Abzazuet/MAP-project/VIdeo/Fotos/todo.jpeg

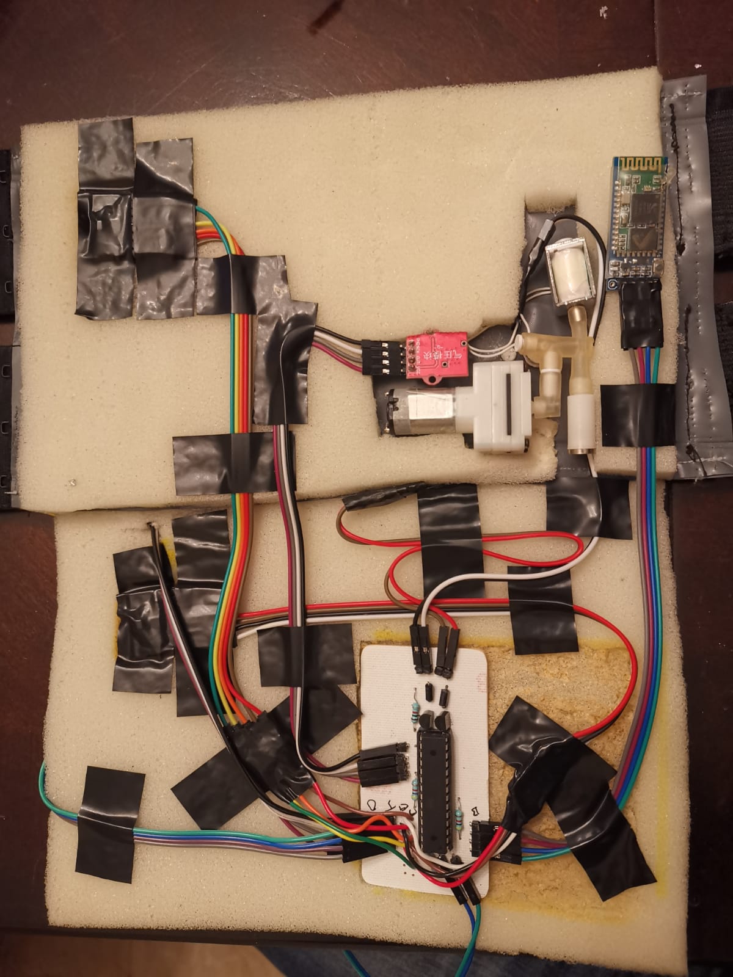
VIdeo/Fotos/todo.jpeg
