Abzazuet/MAP-project/VIdeo/Fotos/intro1.jpeg

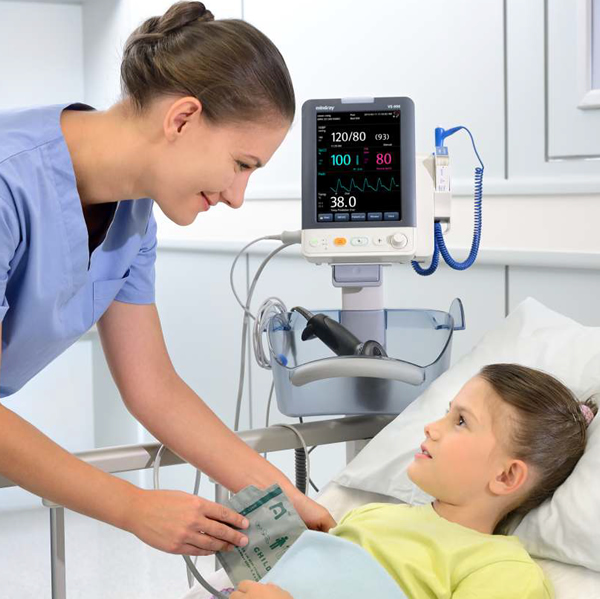
VIdeo/Fotos/intro1.jpeg
