Abzazuet/MAP-project/VIdeo/SeparacionVoces.odt

Daniela

Parte 1: Introducción, planteamiento del problema, antecedentes, justificación

Introducción: Conforme la humanidad va avanzando en tecnología se van buscando nuevos métodos para saber lo que pasa dentro del cuerpo humano y monitorizar los signos vitales para saber sí se tiene un buen estado de salud.

Hoy en día en el mundo se estima que al menos un 50% de la población mayor a los 50 años presenta problemas relacionados con el corazón.

Entre estos signos vitales se encuentra la presión arterial, el cual es el de nuestro mayor interés. Esto debido a que nos da una visión de lo que pasa con el corazón, dado que una presión alta puede indicar hipertensión o esfuerzo de más por parte del corazón. Y una presión baja puede presentar una deficiencia en los niveles de azúcar en la sangre

Justificación:

Este brazalete nos permitirá un monitoreo constante el cual vaya guardando registro de los pulsos por minuto, de la temperatura y de la PANI.

El módulo de biomecánica se acredita dado que el brazalete contiene dos giroscopios para sensar que la posición del brazo sea la adecuada y que así se obtenga una medición acertada.

El módulo de electrofisiología médica se acredita con el uso de sensores de oximetría, temperatura y presion arterial, sensando así signos vitales que pueden dar una noción más acertada de lo que está sucediendo

El módulo de instrumentación se acredita con la elaboración de un brazalete el cual va a tener todos estos sensores y puede ser analogado al monitor de signos vitales.

Guillermo

Parte 2: resultados y análisis de resultados

Resultados:

Ahora una demostración para explicar el funcionamiento de ambas partes concatenadas.

Primero el sujeto se coloca el brazalete, después se ingresa a la aplicación y se conecta al brazalete. Una vez conectado se habilita la opción de iniciar la medición y el brazalete comienza a inflarse.

Una vez terminado el proceso de inflado el microntrolador manda los datos al celular y esta la opción de guardar la medición en caso de que se quiera o está la opción de iniciar otra medición.

Una vez guardada la medicion nos podemos ir al menu de informes, donde nos aparecerán los datos guardados, organizados por fecha.

También está la opción de modificar los datos personales y de agregar una imagen de la persona.

Análisis de resultados:

Abel

Parte 3: Metodología

Para poder lograr acabo el proyecto este se dividio en dos partes fundamentales. La primera fue la programación de una aplicación móvil diseñada en el lenguaje dart con la extensión de flutter, la cual nos permiten hacer aplicaciones con estética y alta funcionalidad. En este mismo apartado se incluyo la programación del microcontrolador (el cual fue un ATMega 8), el cual fue programado en C con la librería avrdude, la cual nos permite programar microcontroladores de la tecnología AVR.

El siguiente apartado fue el armado del brazalete donde se concateno el microcontrolador para sensar los sensores de posición, temperatura, presión y pulso. Para que el brazalete tuviera funcionalidad y pudiera regresar a su estado original se utilizó un tipo de plástico, el cual tiene la capacidad de aguantar presiones que llegan a los 160mmHg (aunque lo que se utiliza aire, estas son las unidades en las que se presenta la PANI). Una vez teniendo la parte del brazalete que se infla se procedió a poner una espuma por debajo del brazalete, esto con el fin de que haya la menor incomodidad posible y también con el fin de poner los sensores que requieren de contacto con la persona que utilice el brazalete. El paso final fue colocal la tarjeta electrónica en el brazalete para que se comuniquen los sensores, el brazalete, el microcontrolador y nuestro celular. El celular y el brazalete se comunican por un modulo de bluetooth, el HC-05.
