Abzazuet/MAP-project/VIdeo/Fotos/androidstudio.jpeg

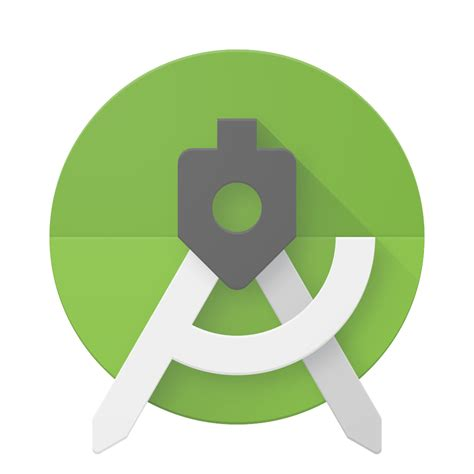
VIdeo/Fotos/androidstudio.jpeg
