Abzazuet/MAP-project/VIdeo/Fotos/atmega8.jpeg

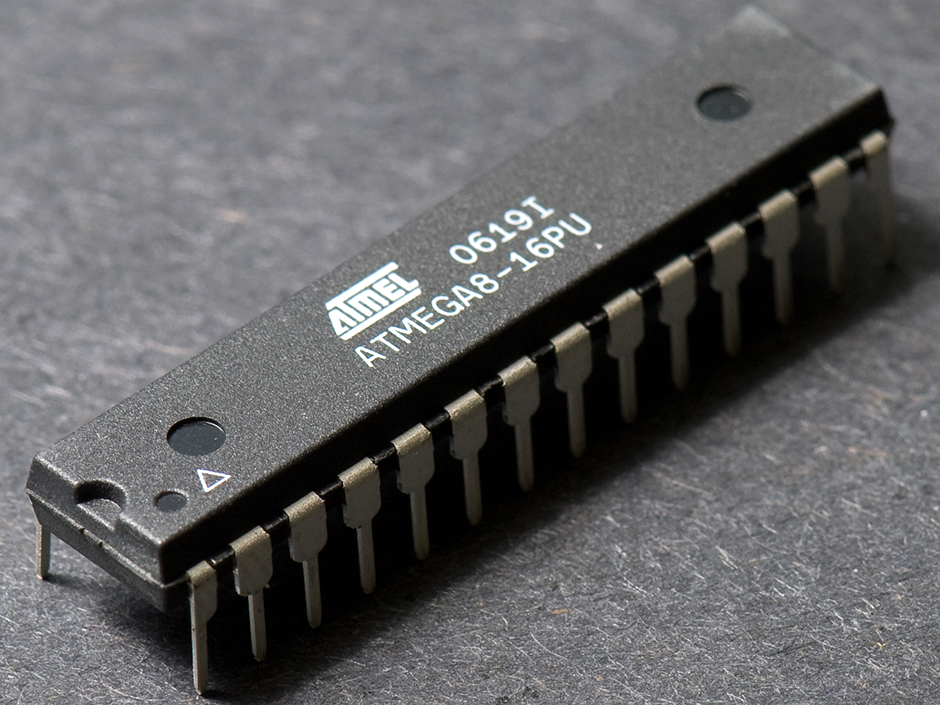
VIdeo/Fotos/atmega8.jpeg
