Abzazuet/MAP-project/VIdeo/Fotos/avr.jpeg

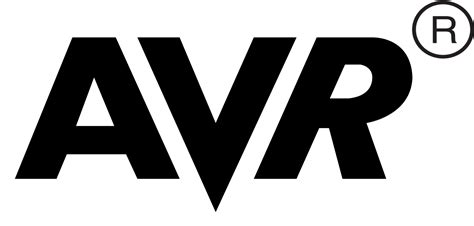
VIdeo/Fotos/avr.jpeg
