Abzazuet/MAP-project/VIdeo/Fotos/brazalete.jpeg

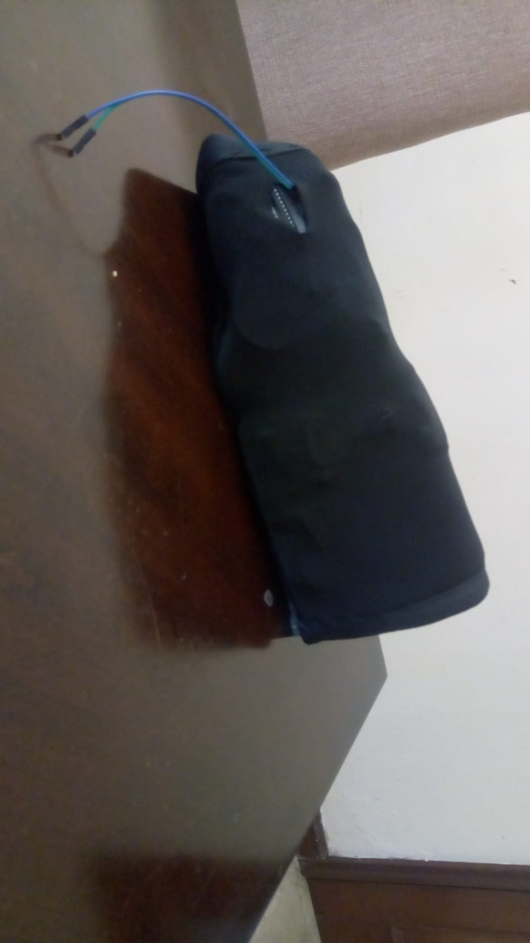
VIdeo/Fotos/brazalete.jpeg
