Abzazuet/MAP-project/VIdeo/Fotos/brazaleteProtipo.jpeg

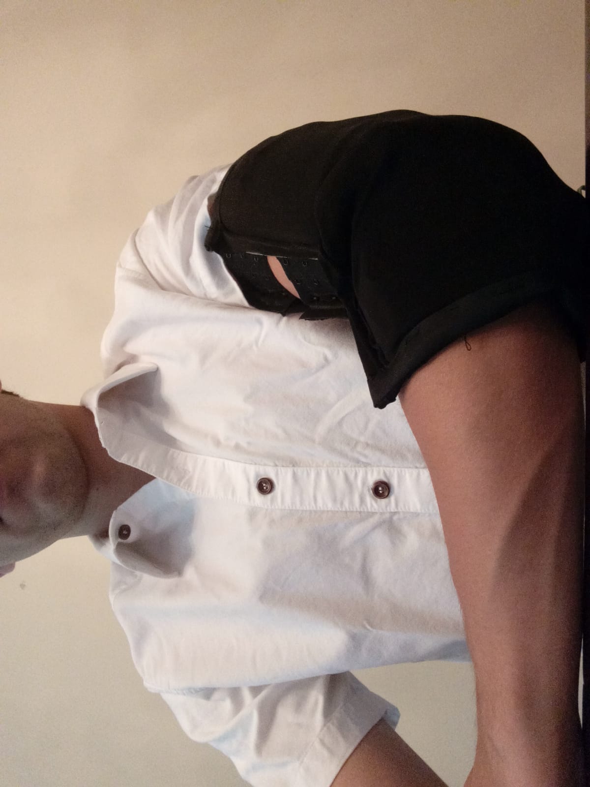
VIdeo/Fotos/brazaleteProtipo.jpeg
