Abzazuet/MAP-project/VIdeo/Fotos/bt.jpeg

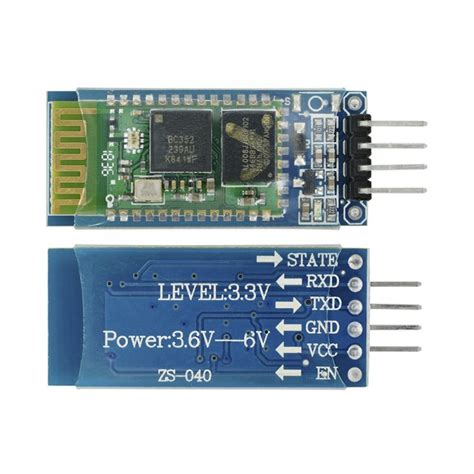
VIdeo/Fotos/bt.jpeg
