Abzazuet/MAP-project/VIdeo/Fotos/corazonInicio.jpg

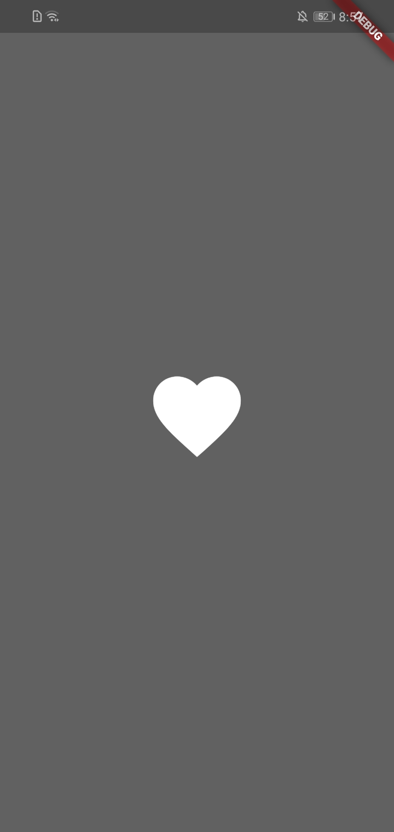
VIdeo/Fotos/corazonInicio.jpg
