Abzazuet/MAP-project/VIdeo/Fotos/Datos.jpg

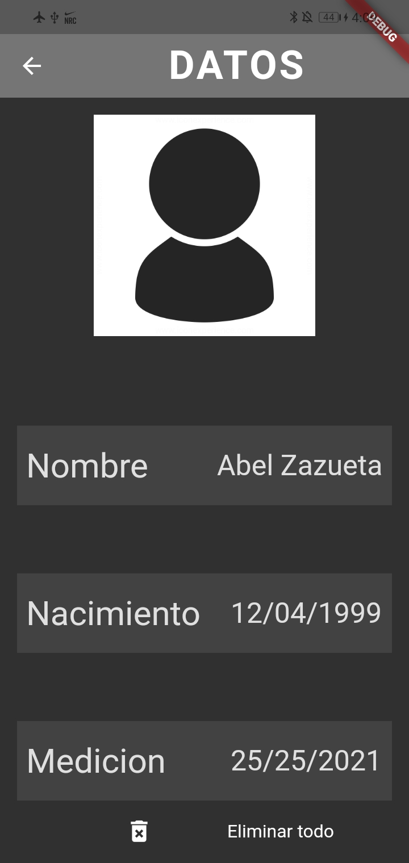
VIdeo/Fotos/Datos.jpg
