Abzazuet/MAP-project/VIdeo/Fotos/espuma.jpeg

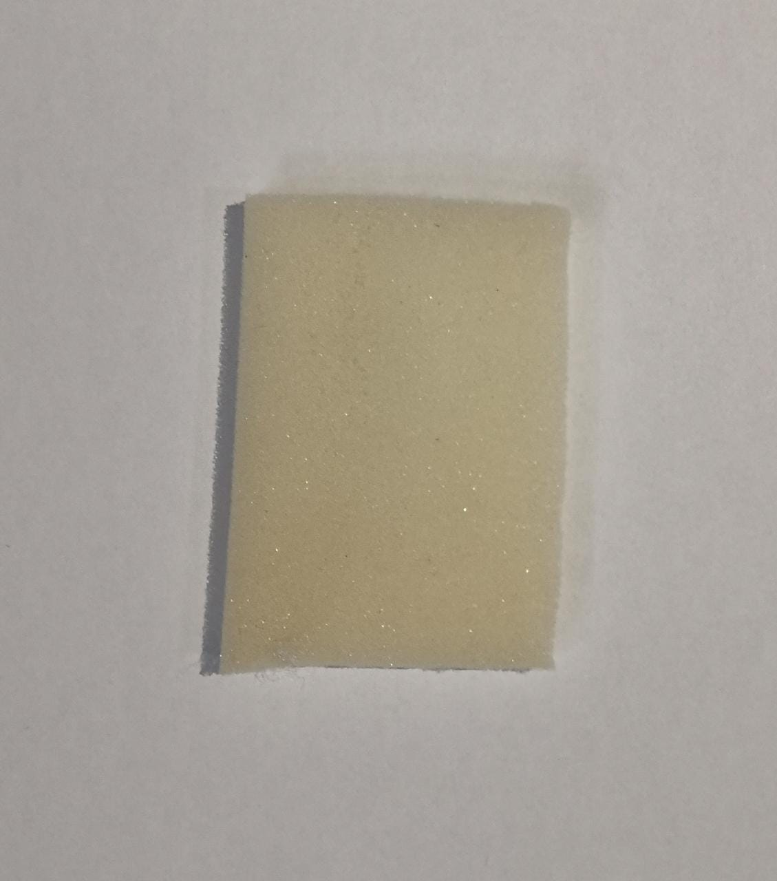
VIdeo/Fotos/espuma.jpeg
