Abzazuet/MAP-project/VIdeo/Fotos/flutterDart.png

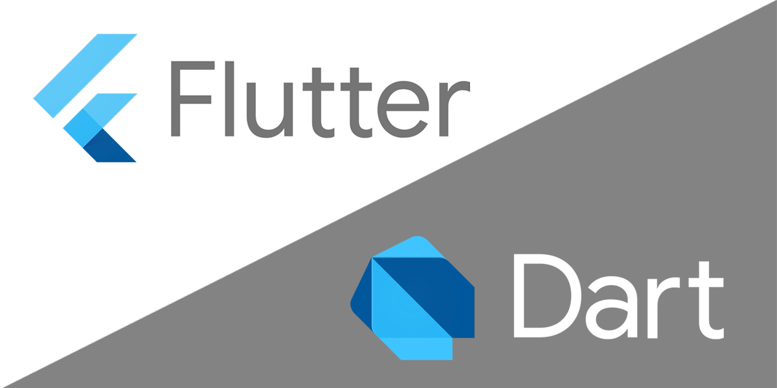
VIdeo/Fotos/flutterDart.png
