Abzazuet/MAP-project/VIdeo/Fotos/giros.jpeg

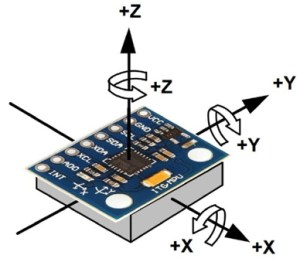
VIdeo/Fotos/giros.jpeg
