Abzazuet/MAP-project/VIdeo/Fotos/girosBrazalete.jpeg

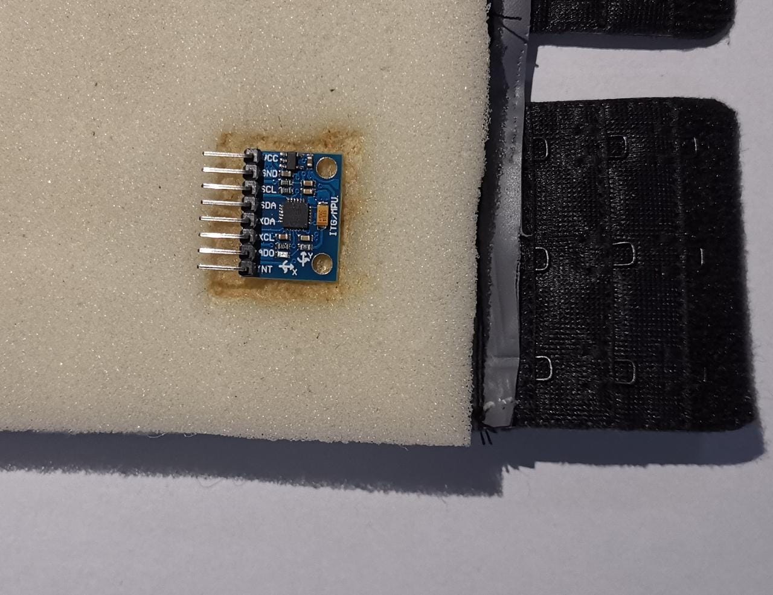
VIdeo/Fotos/girosBrazalete.jpeg
