Abzazuet/MAP-project/VIdeo/Fotos/Informe.jpg

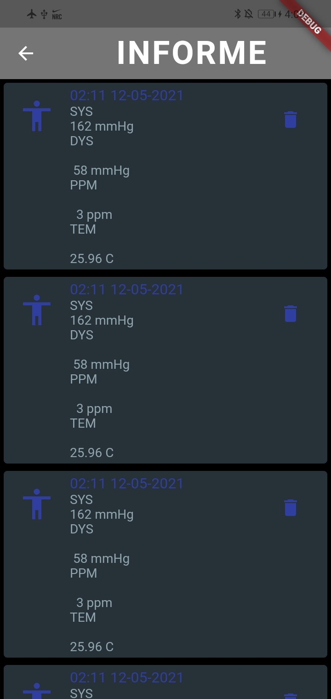
VIdeo/Fotos/Informe.jpg
