Abzazuet/MAP-project/VIdeo/Fotos/Inicio.jpg

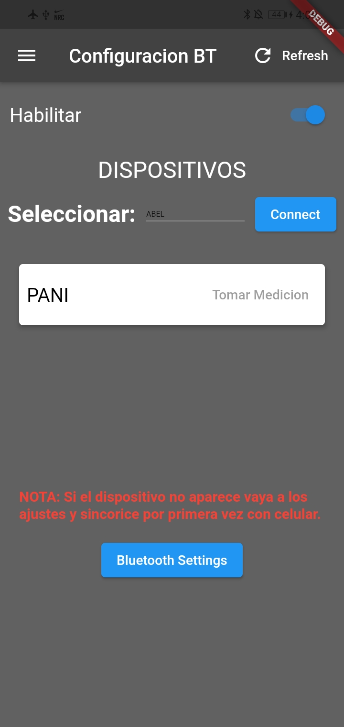
VIdeo/Fotos/Inicio.jpg
