Abzazuet/MAP-project/VIdeo/Fotos/Medicion.jpg

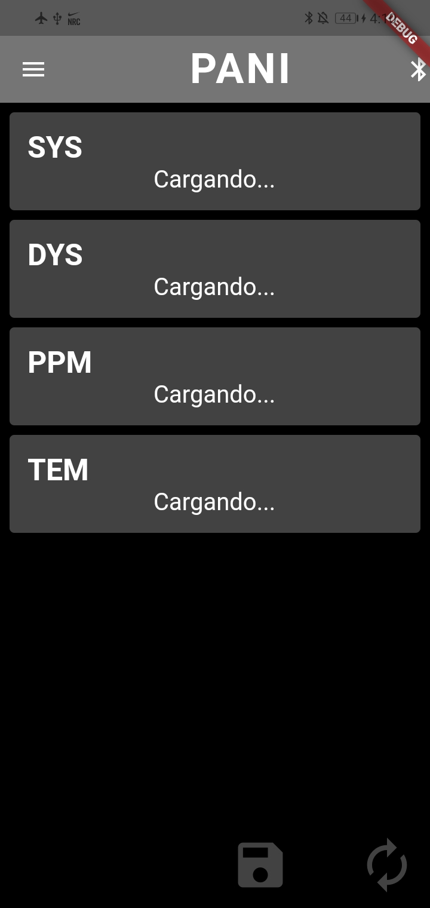
VIdeo/Fotos/Medicion.jpg
