Abzazuet/MAP-project/VIdeo/Fotos/motorBrazalete.jpeg

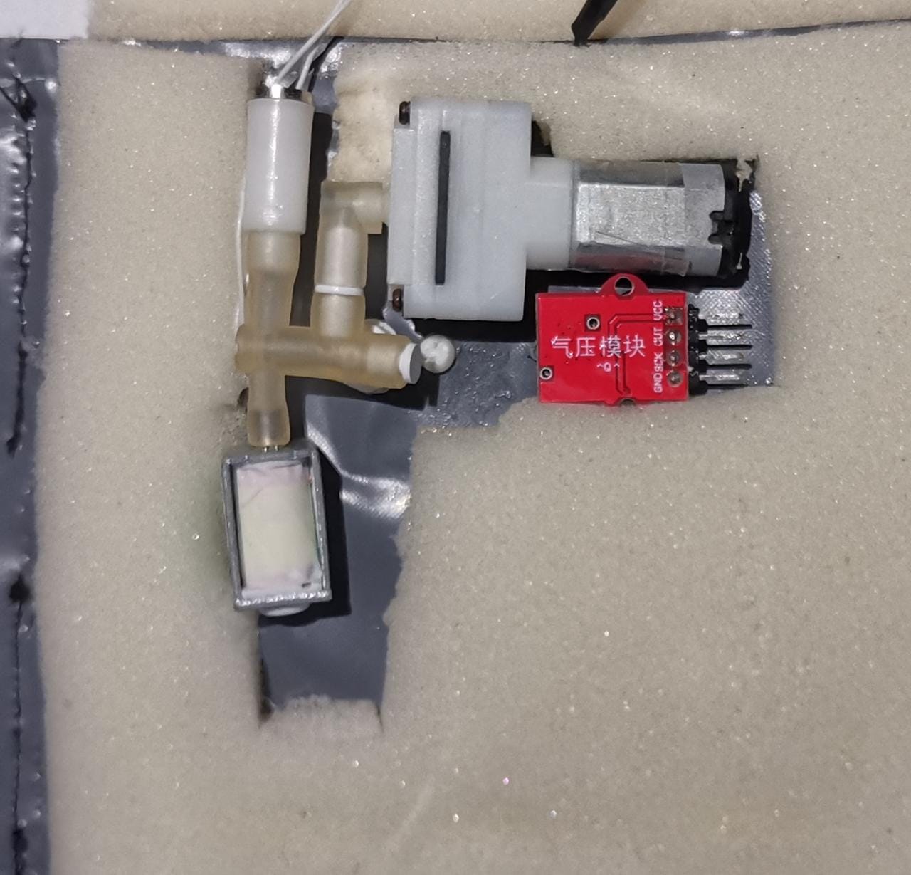
VIdeo/Fotos/motorBrazalete.jpeg
