Abzazuet/MAP-project/VIdeo/Fotos/msv.jpeg

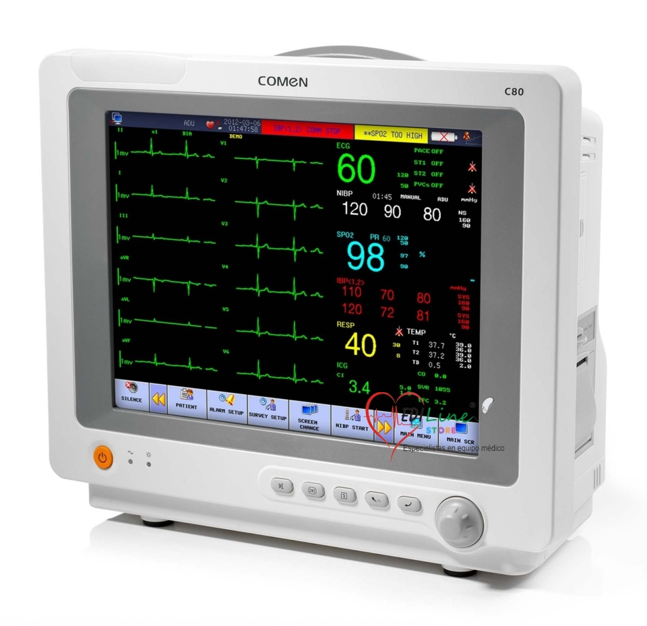
VIdeo/Fotos/msv.jpeg
