Abzazuet/MAP-project/VIdeo/Fotos/Opciones.jpg

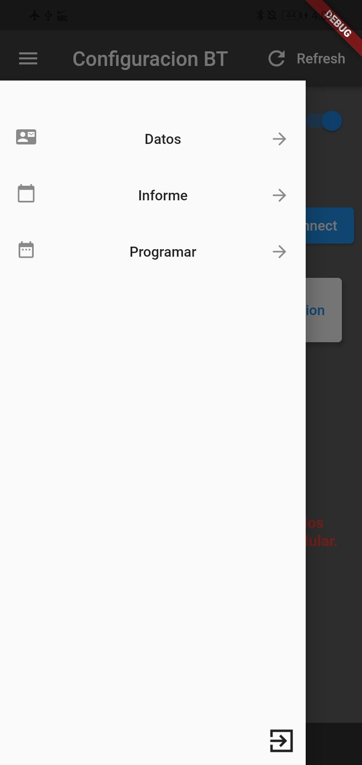
VIdeo/Fotos/Opciones.jpg
