Abzazuet/MAP-project/VIdeo/Fotos/oscilatorio.jpeg

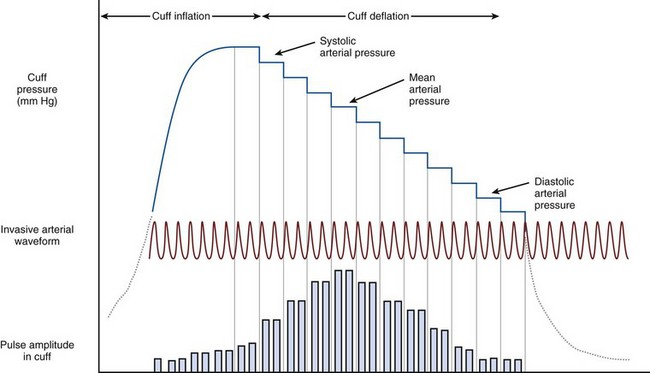
VIdeo/Fotos/oscilatorio.jpeg
