Abzazuet/MAP-project/VIdeo/Fotos/oscilometrico2.png

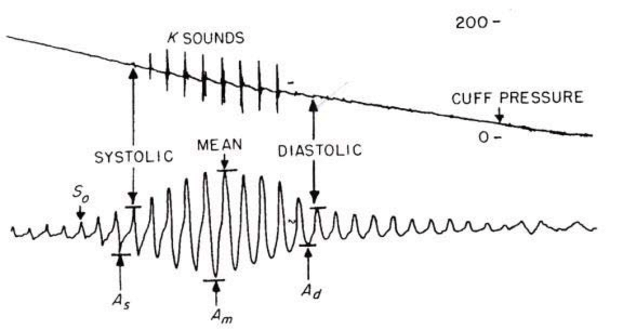
VIdeo/Fotos/oscilometrico2.png
