Abzazuet/MAP-project/VIdeo/Fotos/oximetria.jpeg

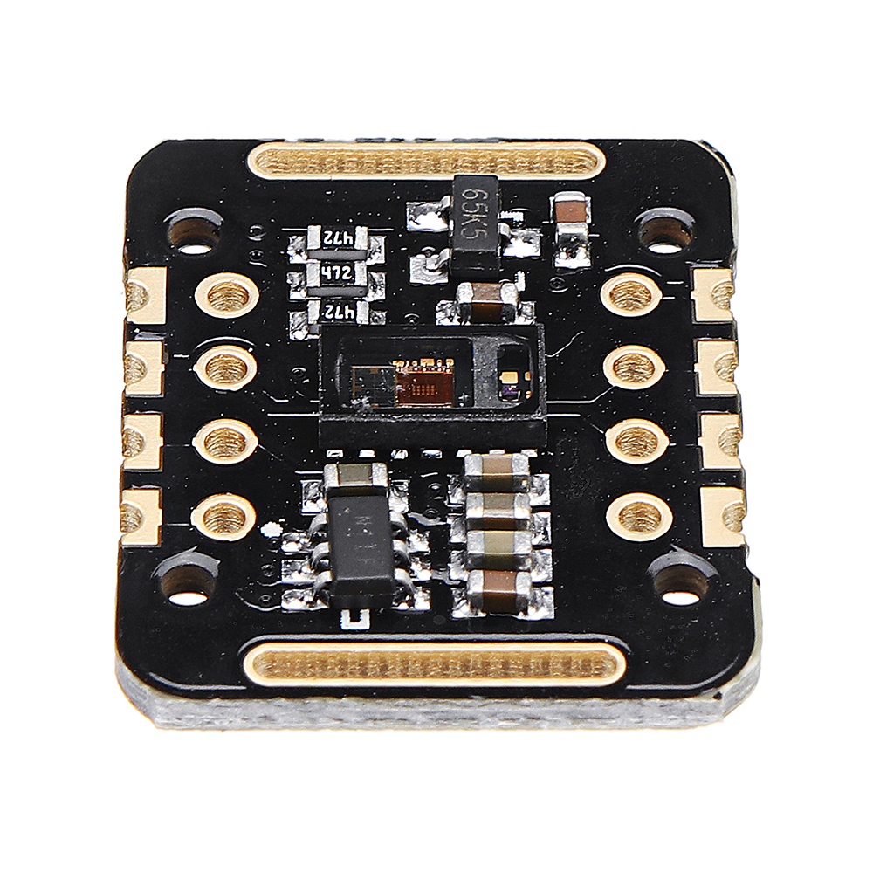
VIdeo/Fotos/oximetria.jpeg
