Abzazuet/MAP-project/VIdeo/Fotos/pesoBrazaleteNuestro.jpeg

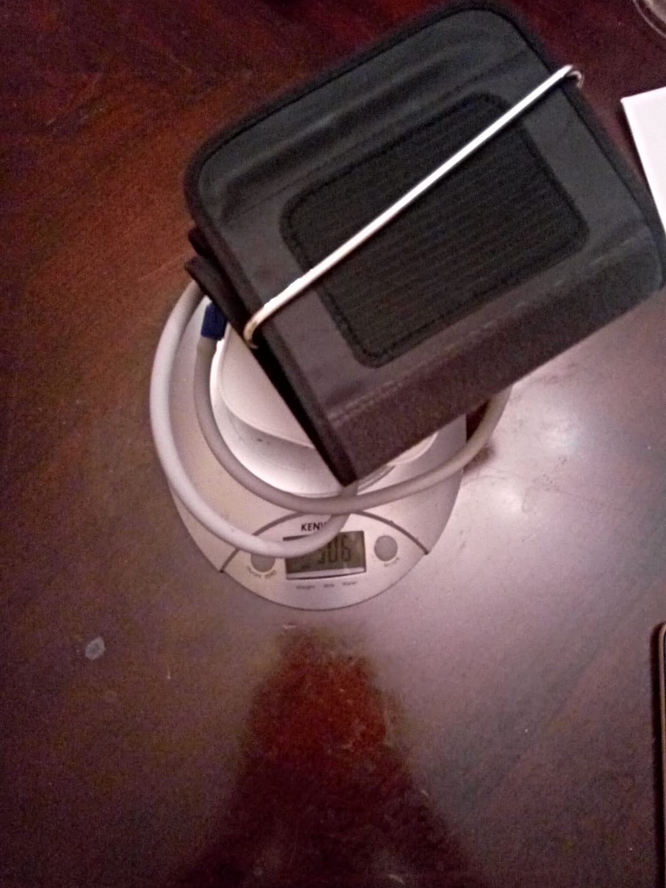
VIdeo/Fotos/pesoBrazaleteNuestro.jpeg
