Abzazuet/MAP-project/VIdeo/Fotos/pesoPrototipo.jpeg

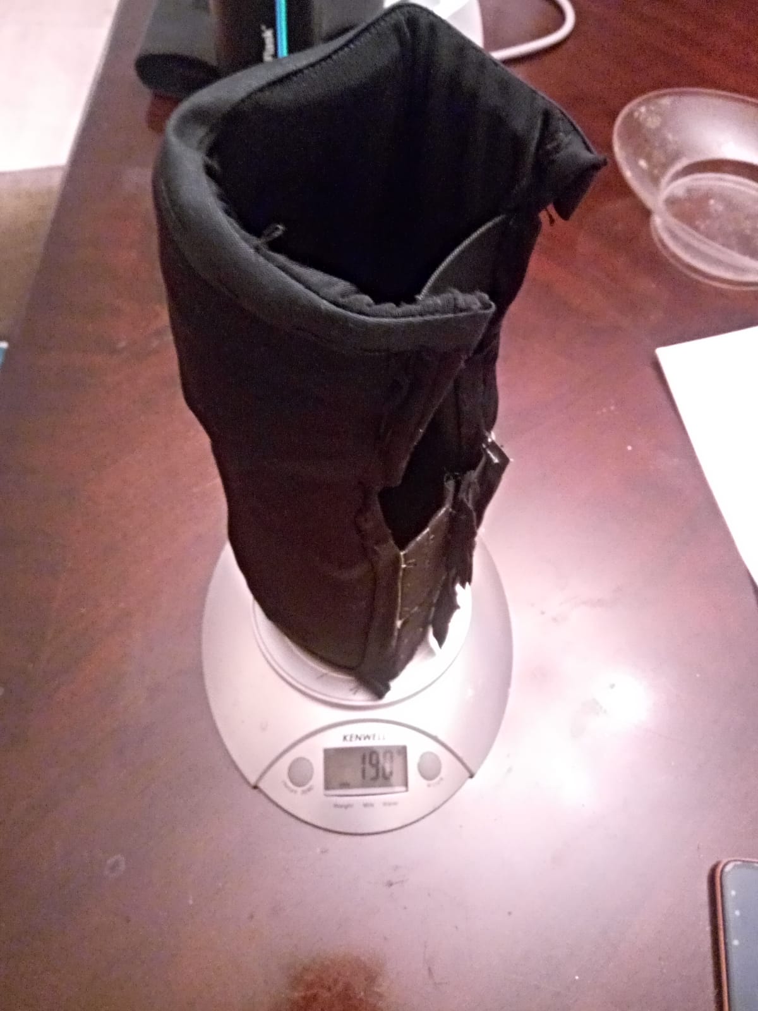
VIdeo/Fotos/pesoPrototipo.jpeg
