Abzazuet/MAP-project/VIdeo/Fotos/presion.jpeg

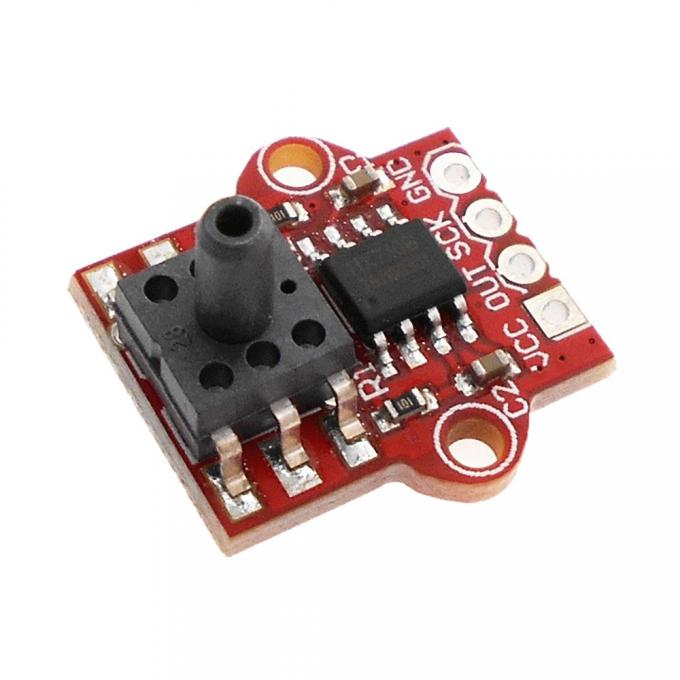
VIdeo/Fotos/presion.jpeg
