Abzazuet/MAP-project/VIdeo/Fotos/resorte.jpeg

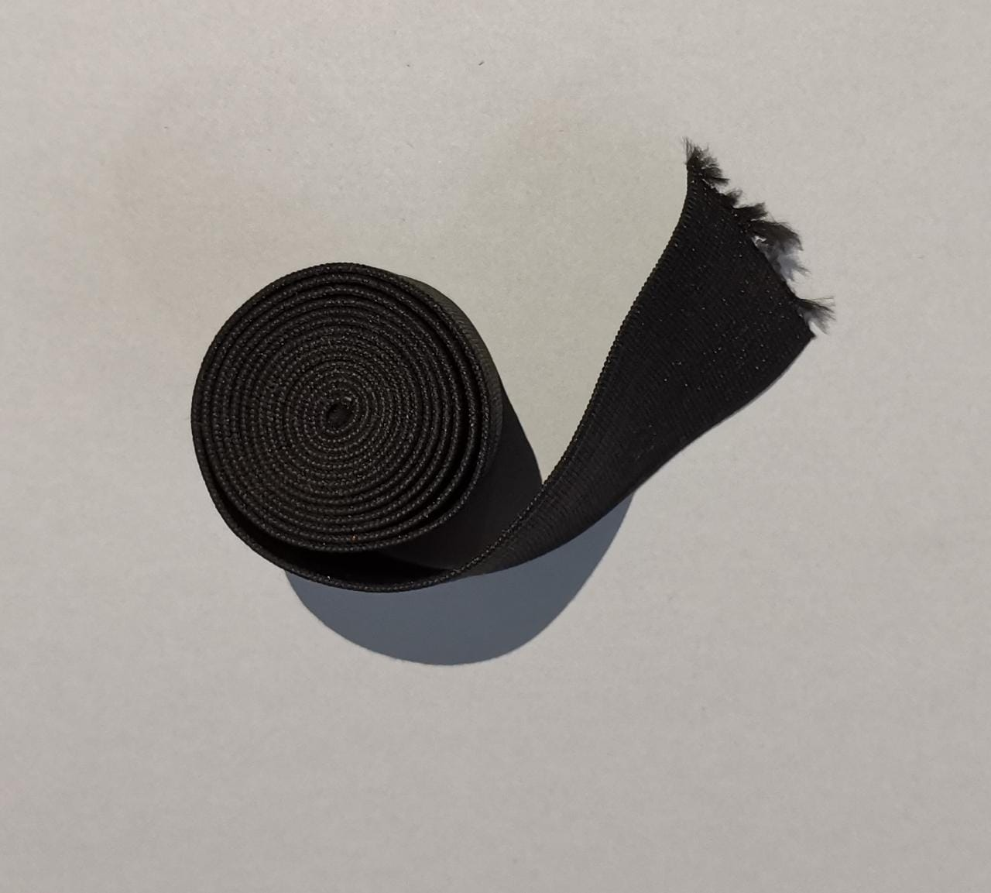
VIdeo/Fotos/resorte.jpeg
