Abzazuet/MAP-project/VIdeo/Fotos/sensoresPiel.jpeg

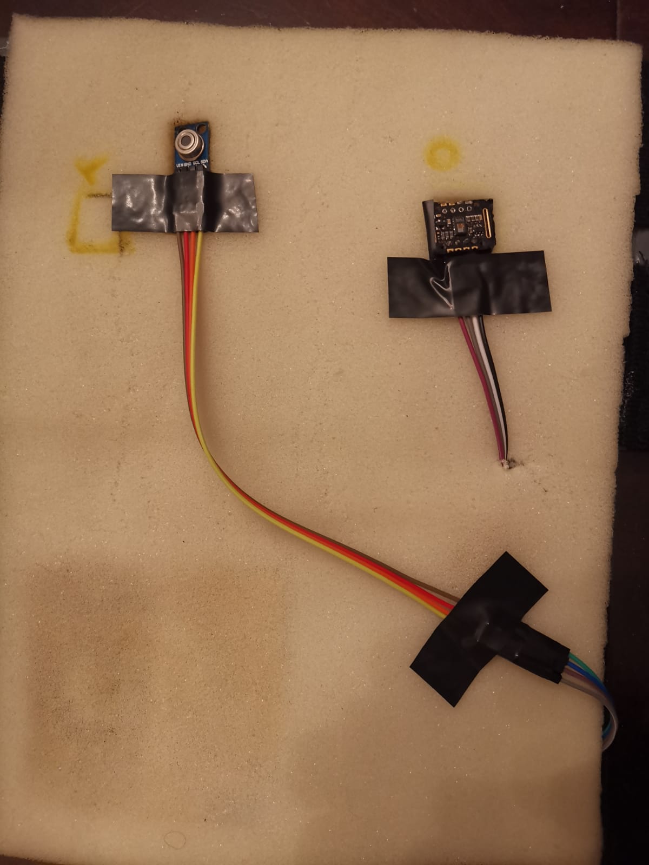
VIdeo/Fotos/sensoresPiel.jpeg
