Abzazuet/MAP-project/VIdeo/Fotos/telaInflable.jpeg

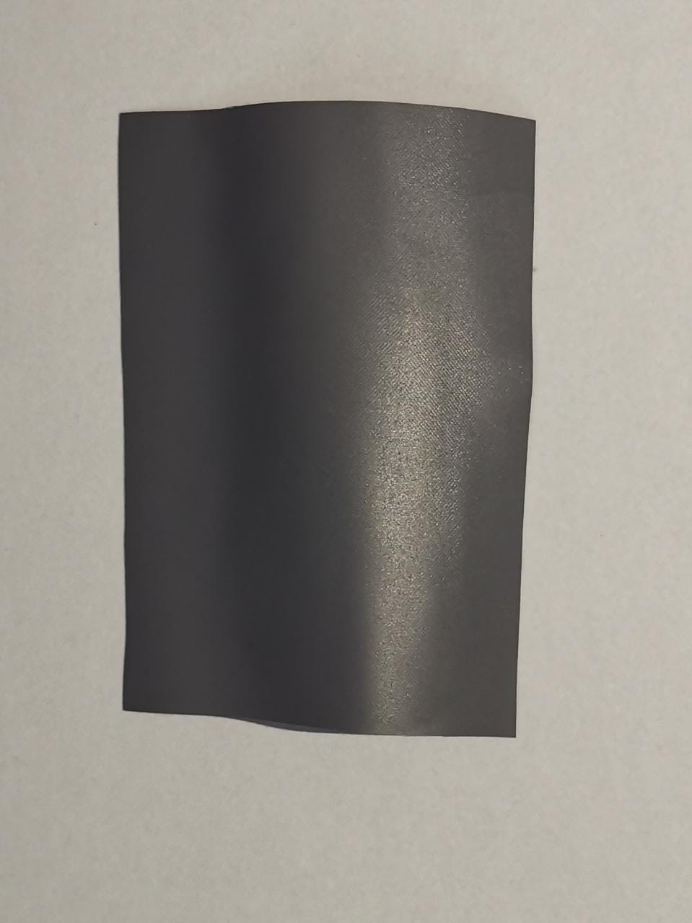
VIdeo/Fotos/telaInflable.jpeg
