Abzazuet/MAP-project/VIdeo/Fotos/temp.jpeg

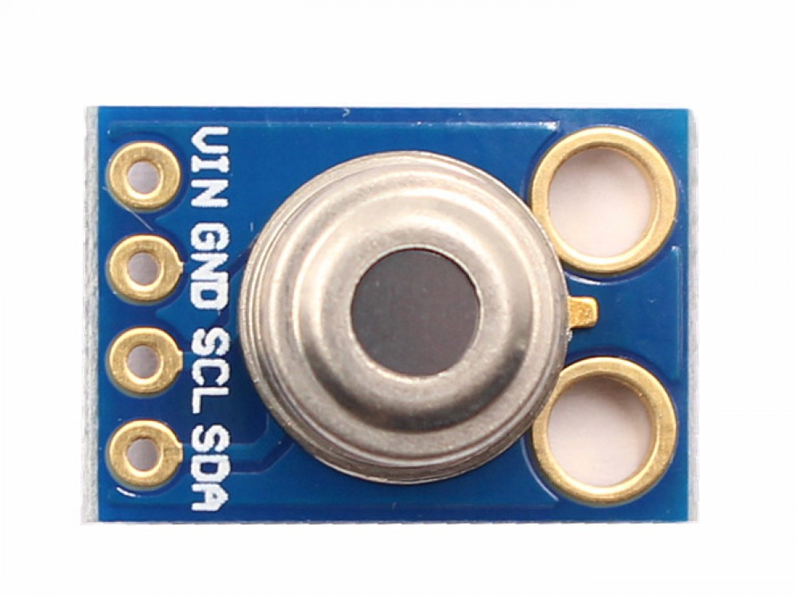
VIdeo/Fotos/temp.jpeg
