Abzazuet/MAP-project/(list of files, cad)

Other CAD files:
VIdeo/ProyectoModular.blend
