Abzazuet/MAP-project/pcb/pcb-esquematico.pdf

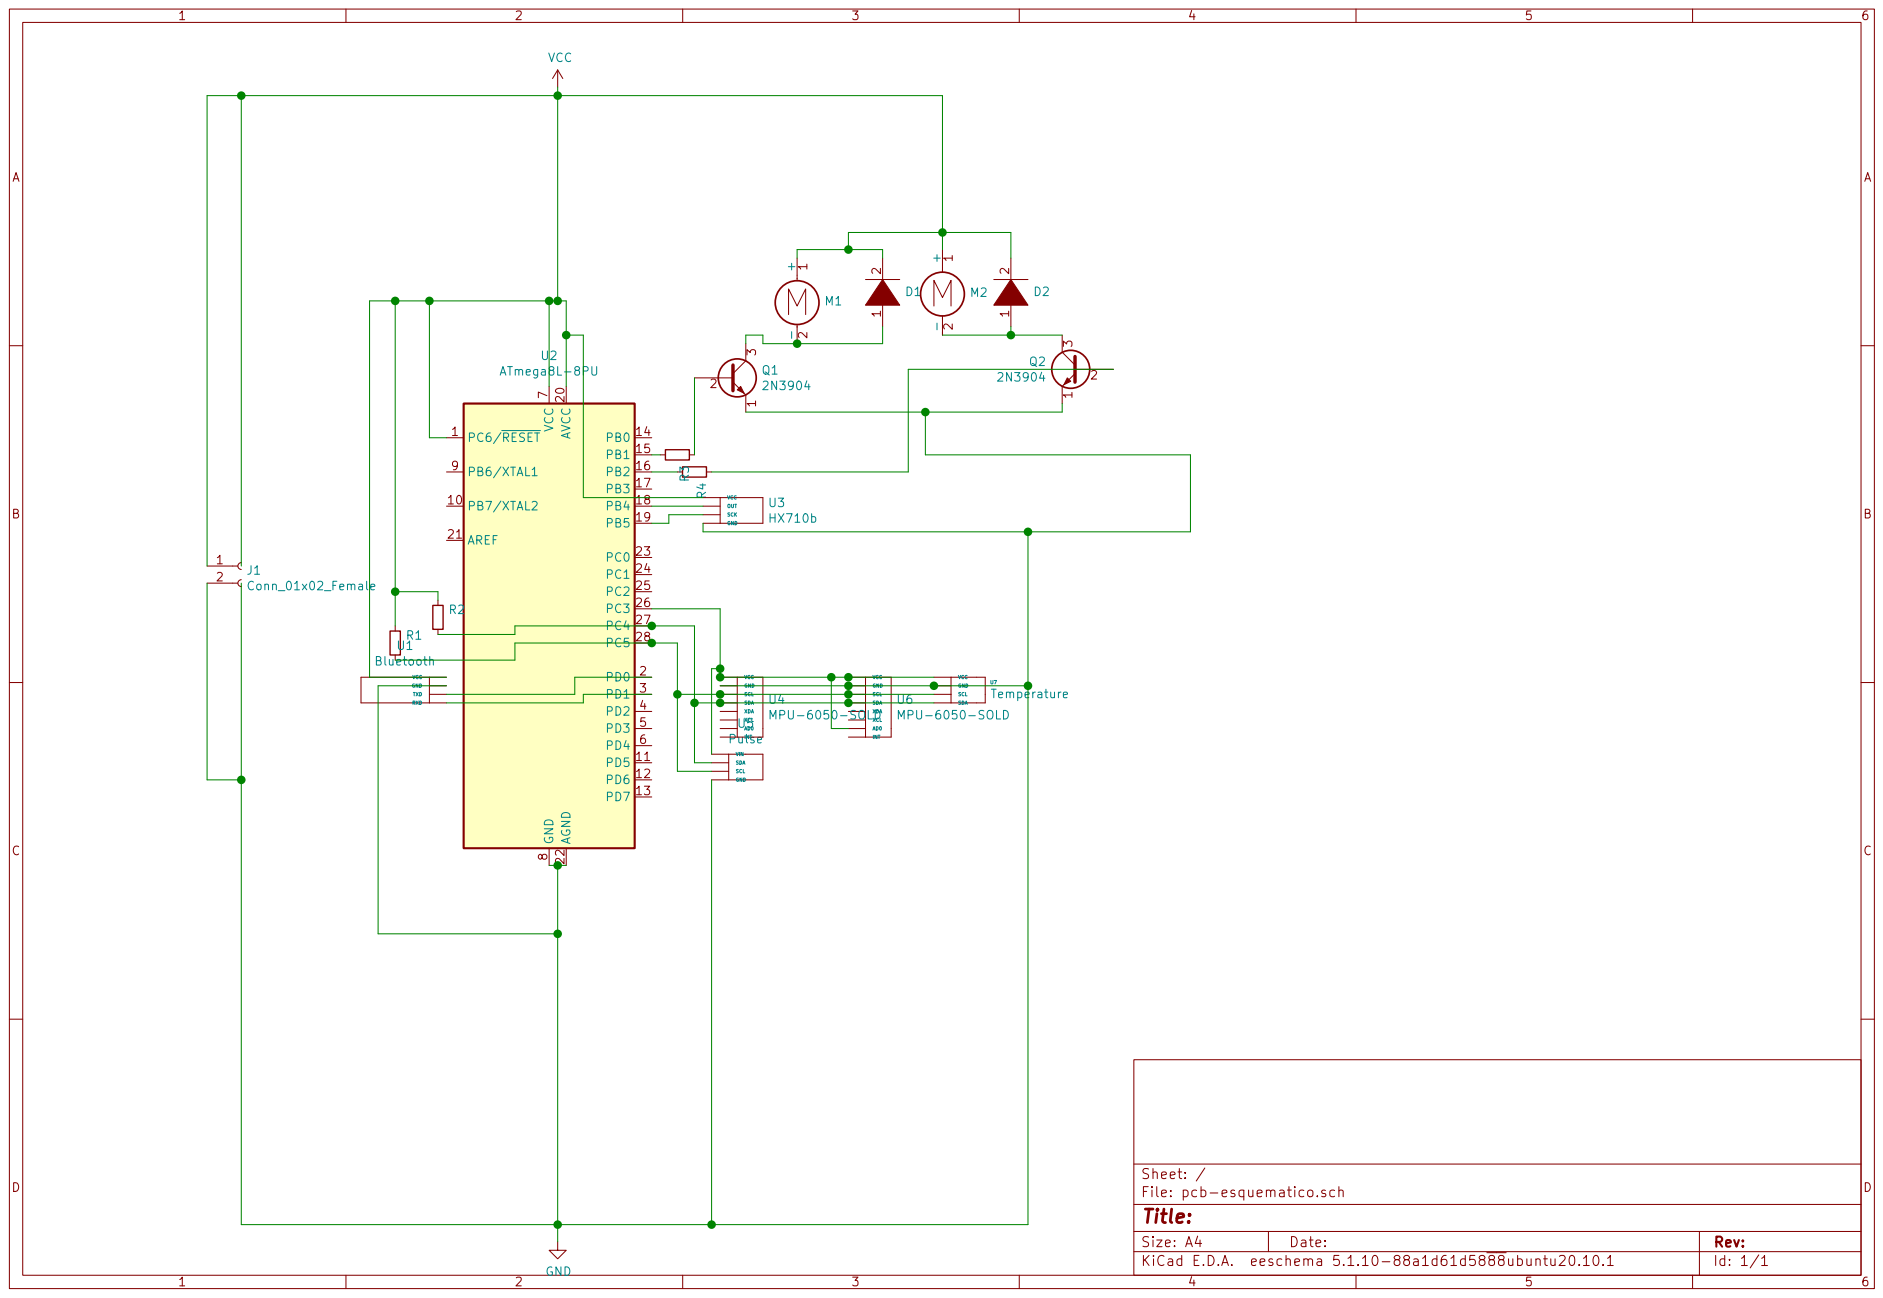
[picture p31: page 1]

SCL GND U5 Pulse R4 R3 GND
