Abzazuet/MAP-project/pcb/pcb2-F_Cu.pdf

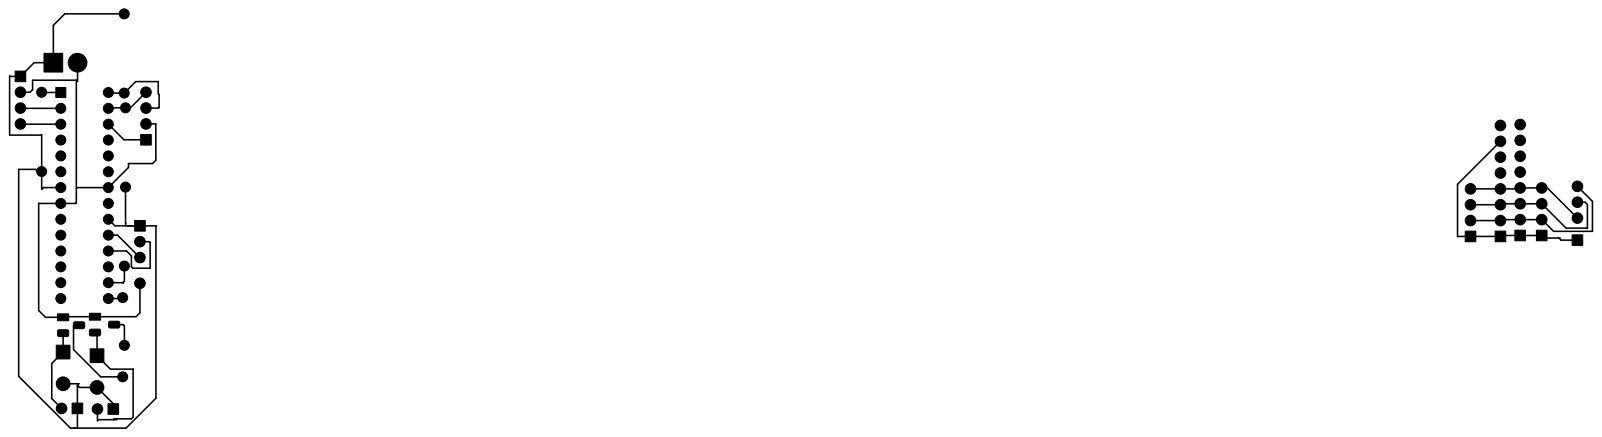
[picture p32: page 1]
