Abzazuet/MAP-project/pcb/pcb_esquematico-F_Cu.pdf

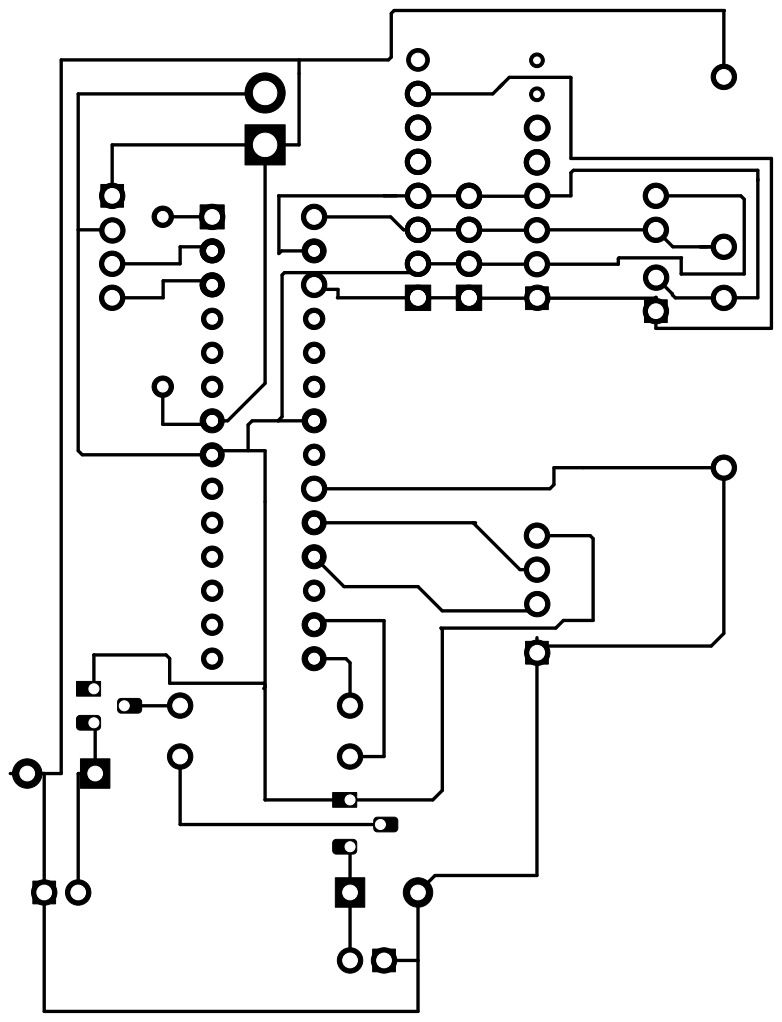
[picture p33: page 1]
