Abzazuet/MAP-project/pcb/pcb_esquematico.kicad_pcb

## KiCad design pcb/pcb_esquematico.kicad_pcb (2021-11-09)

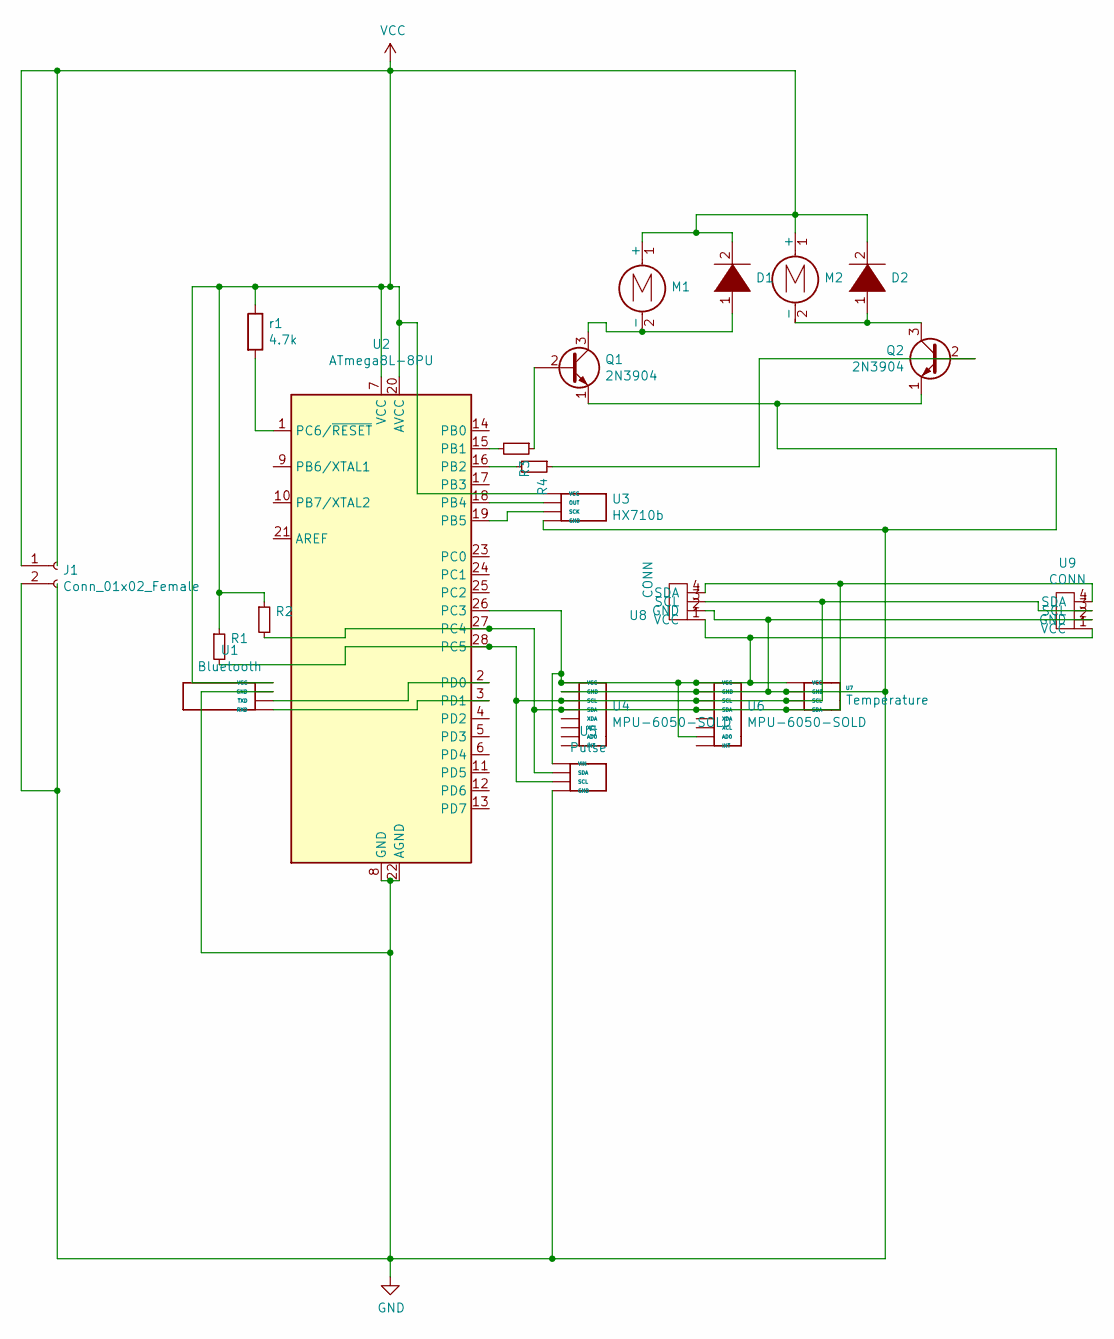
[picture p34: schematic pcb-esquematico.sch]

Parts:
D1: DIODE; D_DO-41_SOD81_P5.08mm_Vertical_KathodeUp
D2: DIODE; D_DO-41_SOD81_P5.08mm_Vertical_AnodeUp
J1: Conn_01x02_Female; JWT_A3963_1x02_P3.96mm_Vertical
M1, M2: Motor_DC; PinHeader_1x02_P2.54mm_Horizontal
Q1, Q2: 2N3904; TO-92_HandSolder
R1, R2: 4700; R_Axial_DIN0309_L9.0mm_D3.2mm_P12.70mm_Horizontal
R3, R4: 1000; R_Axial_DIN0309_L9.0mm_D3.2mm_P12.70mm_Horizontal
U1: Bluetooth; PinHeader_1x04_P2.54mm_Vertical
U2: ATmega8L-8PU; DIP-28_W7.62mm
U3: HX710b; PinHeader_1x04_P2.54mm_Vertical
U4, U6: MPU-6050-SOLD; PinHeader_1x08_P2.54mm_Vertical
U5: Pulse; PinHeader_1x04_P2.54mm_Vertical
U7: Temperature; PinHeader_1x04_P2.54mm_Vertical
U8, U9: CONN; PinSocket_1x04_P2.54mm_Horizontal
r1: 4.7k; R_Axial_DIN0309_L9.0mm_D3.2mm_P12.70mm_Horizontal

Connections:
GND: J1.2, Q1.1 (E), Q2.1 (E), U1.2 (GND), U2.8 (GND), U2.22 (AGND), U3.4 (GND), U4.2 (GND), U5.4 (GND), U6.2 (GND), U7.2 (GND), U8.2 (GND), U9.2 (GND)
unnamed: D1.1 (K), M1.2 (-), Q1.3 (C)
unnamed: D2.1 (K), M2.2 (-), Q2.3 (C)
unnamed: Q1.2 (B), R3.1
unnamed: Q2.2 (B), R4.1
unnamed: R1.2, U2.28 (PC5), U4.3 (SCL), U5.3 (SCL), U6.3 (SCL), U7.3 (SCL), U8.3 (SCL), U9.3 (SCL)
unnamed: R2.2, U2.27 (PC4), U4.4 (SDA), U5.2 (SDA), U6.4 (SDA), U7.4 (SDA), U8.4 (SDA), U9.4 (SDA)
unnamed: R3.2, U2.15 (PB1)
unnamed: R4.2, U2.16 (PB2)
unnamed: U1.3 (TXD), U2.2 (PD0)
unnamed: U1.4 (RXD), U2.3 (PD1)
unnamed: U2.1 (PC6/~RESET), r1.2
unnamed: U2.18 (PB4), U3.2 (OUT)
unnamed: U2.19 (PB5), U3.3 (SCK)
unnamed: U2.26 (PC3), U4.1 (VCC), U5.1 (VIN), U6.1 (VCC), U6.7 (AD0), U7.1 (VCC), U8.1 (VCC), U9.1 (VCC)
VCC: D1.2 (A), D2.2 (A), J1.1, M1.1 (+), M2.1 (+), R1.1, R2.1, U1.1 (VCC), U2.7 (VCC), U2.20 (AVCC), U3.1 (VCC), r1.1

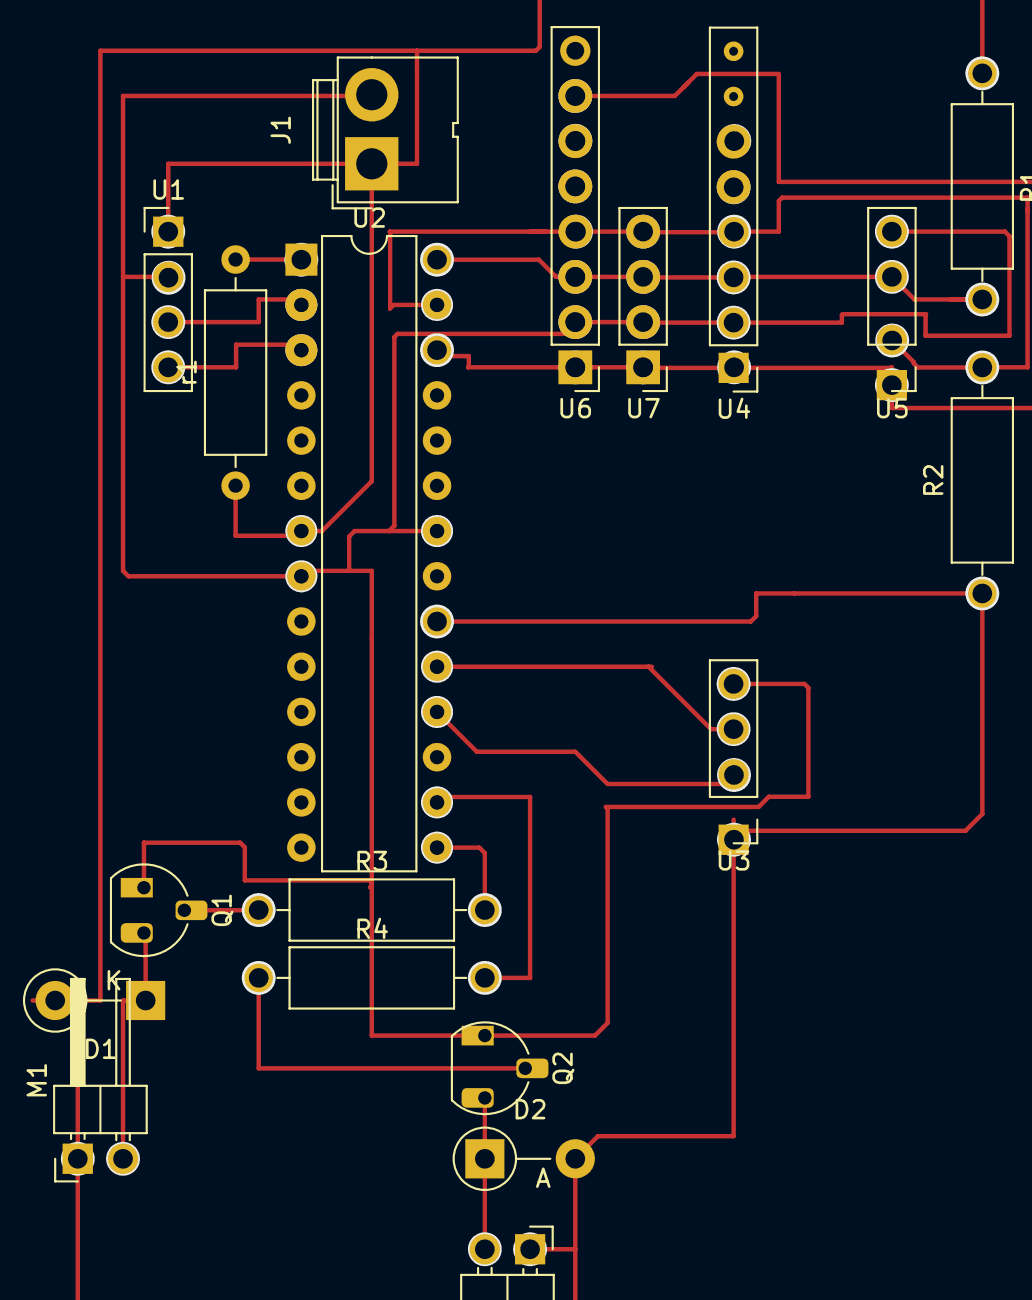
[picture p35: board pcb_esquematico.kicad_pcb from above]

Board: 2 copper layers, 19 parts (0 on the bottom side), 16 nets.
